Kris-Sekula/NABU/ProtoPCB/Readme.md

Simple PCB for an ad-hoc build of NABU expansion devices. All NABU signals are labeled for ease of connection.

Sources are in KiCad 6.0, you can use those to create gerbers or simply order from [PCBWay](https://www.pcbway.com/project/shareproject/NABU_PC_Prototyping_PCB_ee055662.html)

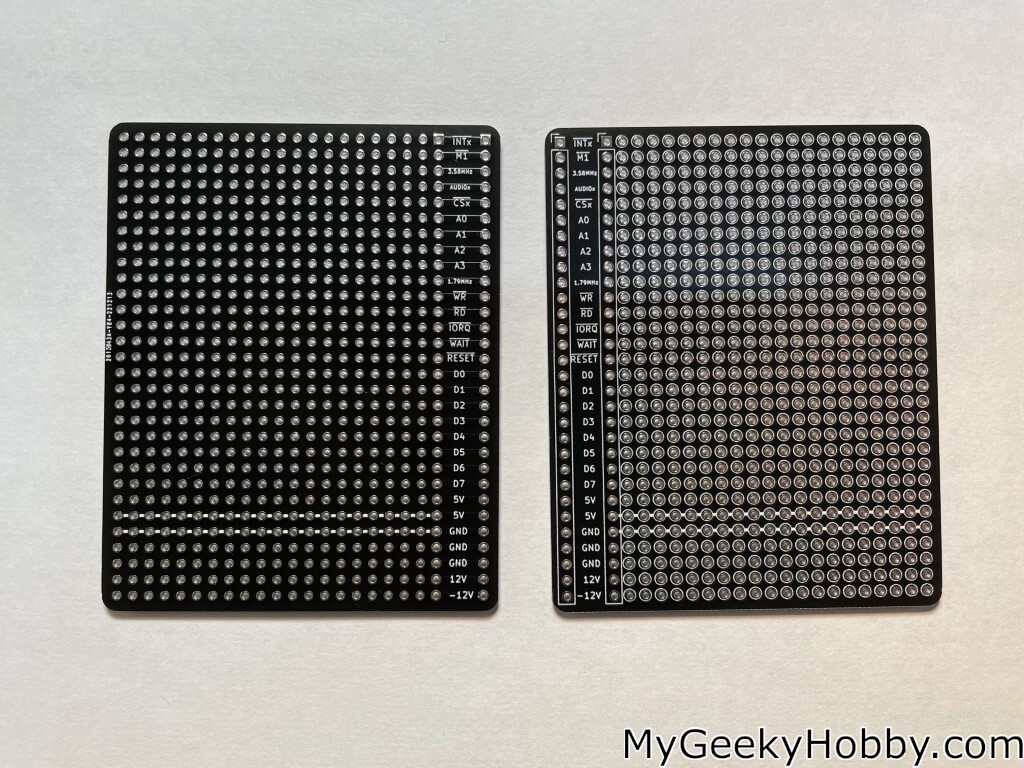
[picture p1: ProtoPCB/Pictures/ProtoPCB.jpg]
ProtoPCB


And here is an example of using the proto PCB to build a CF card adapter for NABU and run CP/M (as per those [Instructions](https://github.com/randomvariations/nabu.cpm/tree/main/cpm22))

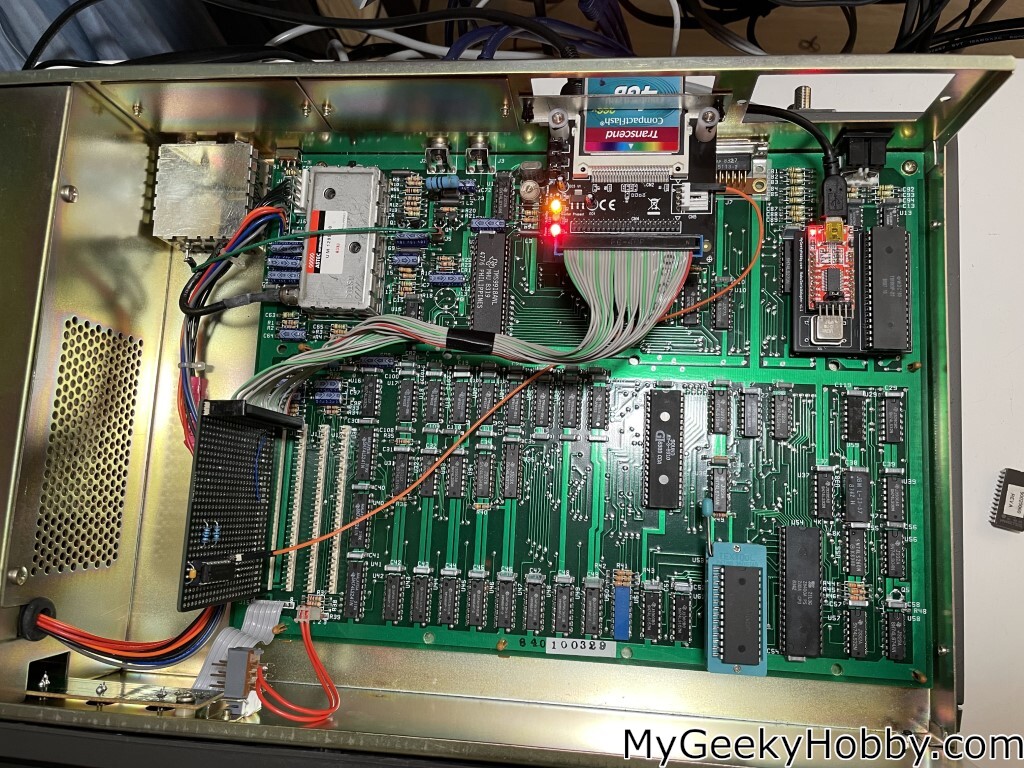
[picture p2: ProtoPCB/Pictures/CF_adapter_usingProto.jpg]
CF_Adapter
