Kris-Sekula/NABU/RS422Alternative/Readme.md

Diagram of a serial port implemented with a simple USB<->TTL adapter and [YouTube-video](https://youtu.be/NxW2GOw5Mqk)

KiCad PCB desing in the hardware folder

It works! ... well it "worked"...fine with the first version of the Nabu software, but now something has changed... so this adapter only works with the alternative "monitor" that I tested ... see my YouTube video.
NABU-Online

Detailed Diagram
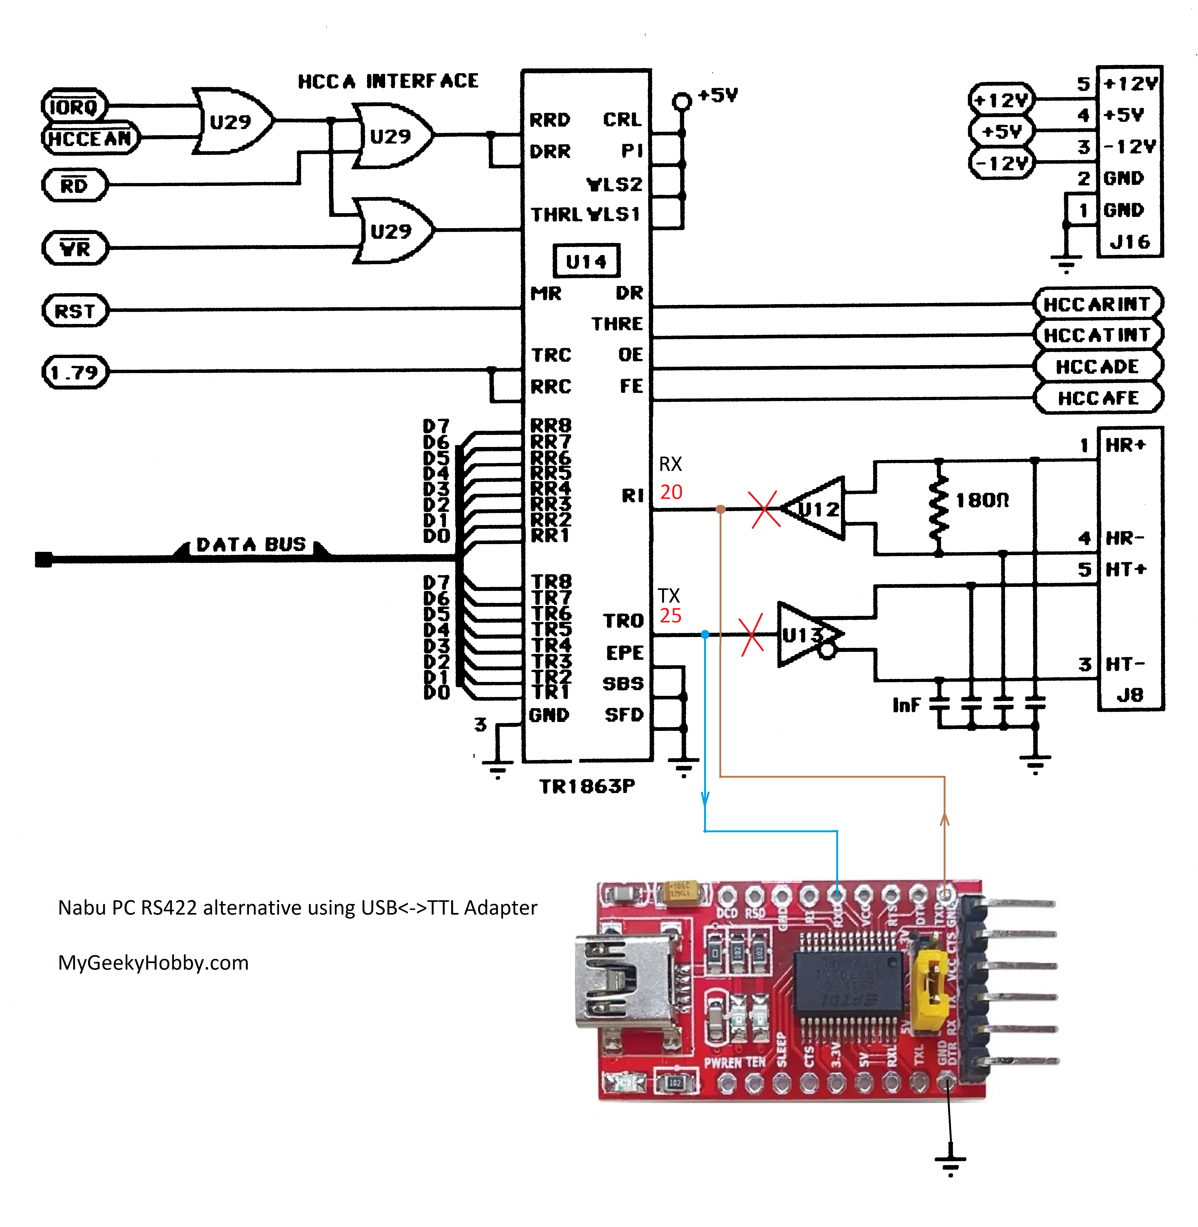
[picture p4: RS422Alternative/USB_interface.png]
USB-serial-Adapter

I'm also testing virtual com port using ESP8266 and the esp-link firmware
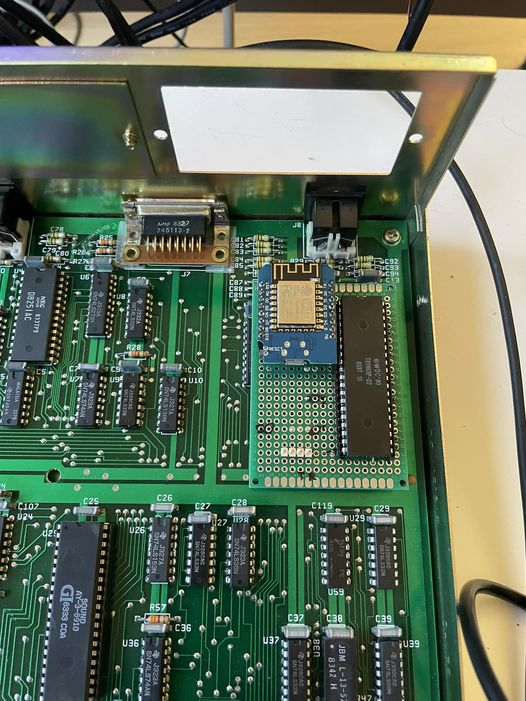
[picture p5: RS422Alternative/esp-nabu.jpg]
esp-link
