Kris-Sekula/NABU/RS422Alternative/Hardware/nabu_serial.pdf

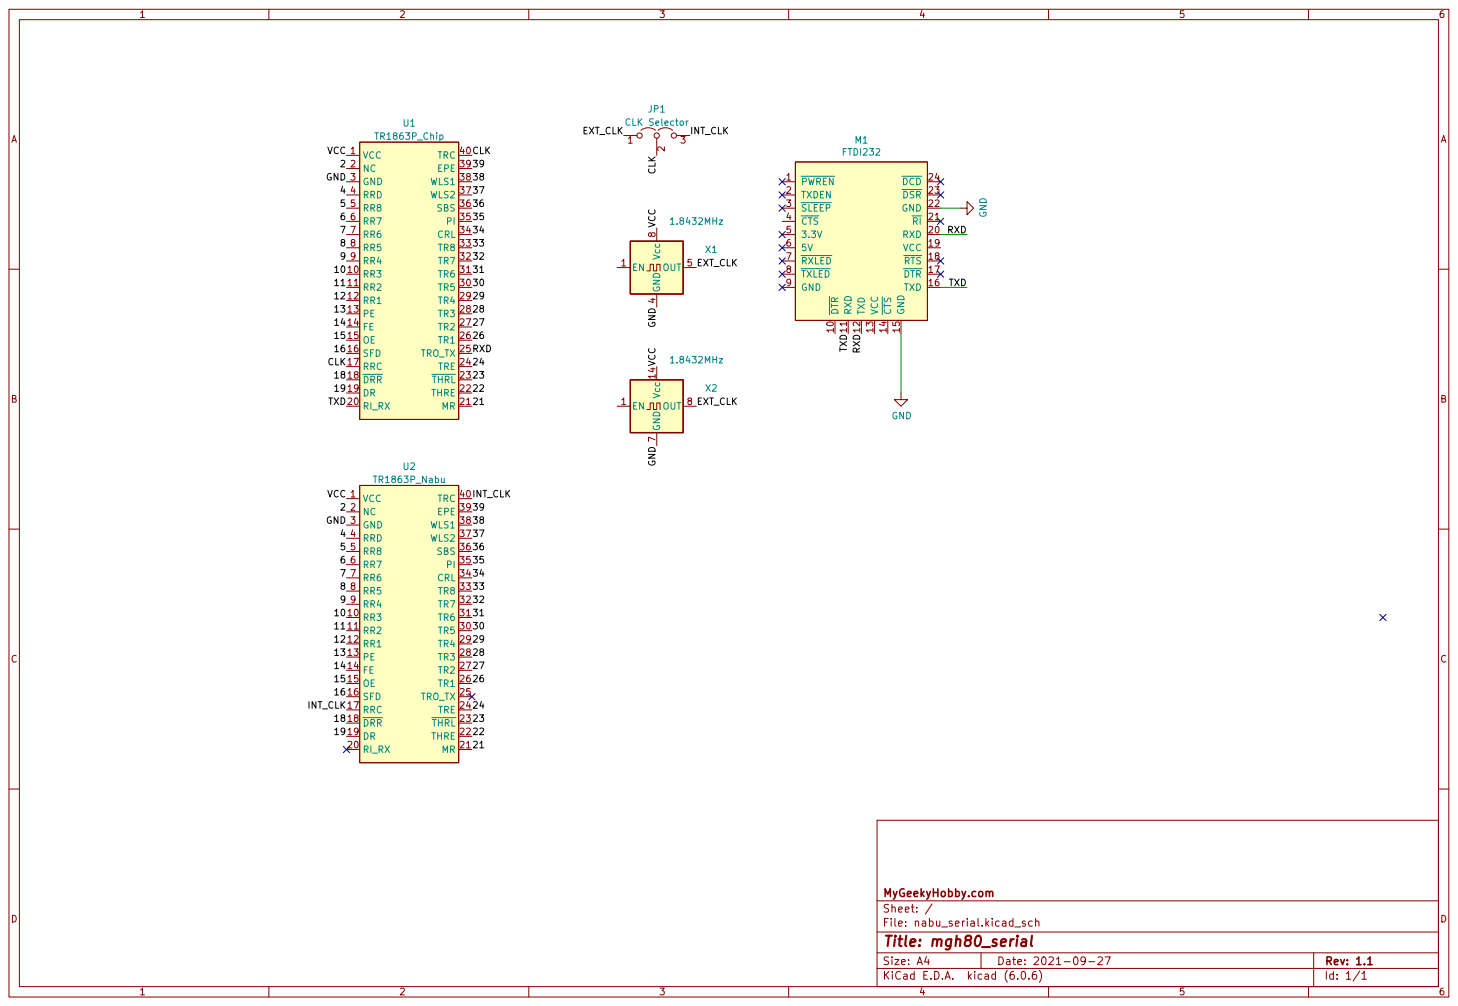
[picture p8: page 1]

File: nabu_serial.kicad_sch Sheet: / MyGeekyHobby.com
