Kris-Sekula/NABU/RS422Alternative/Hardware/nabu_serial.kicad_pcb

## KiCad design RS422Alternative/Hardware/nabu_serial.kicad_pcb (2022-12-31)

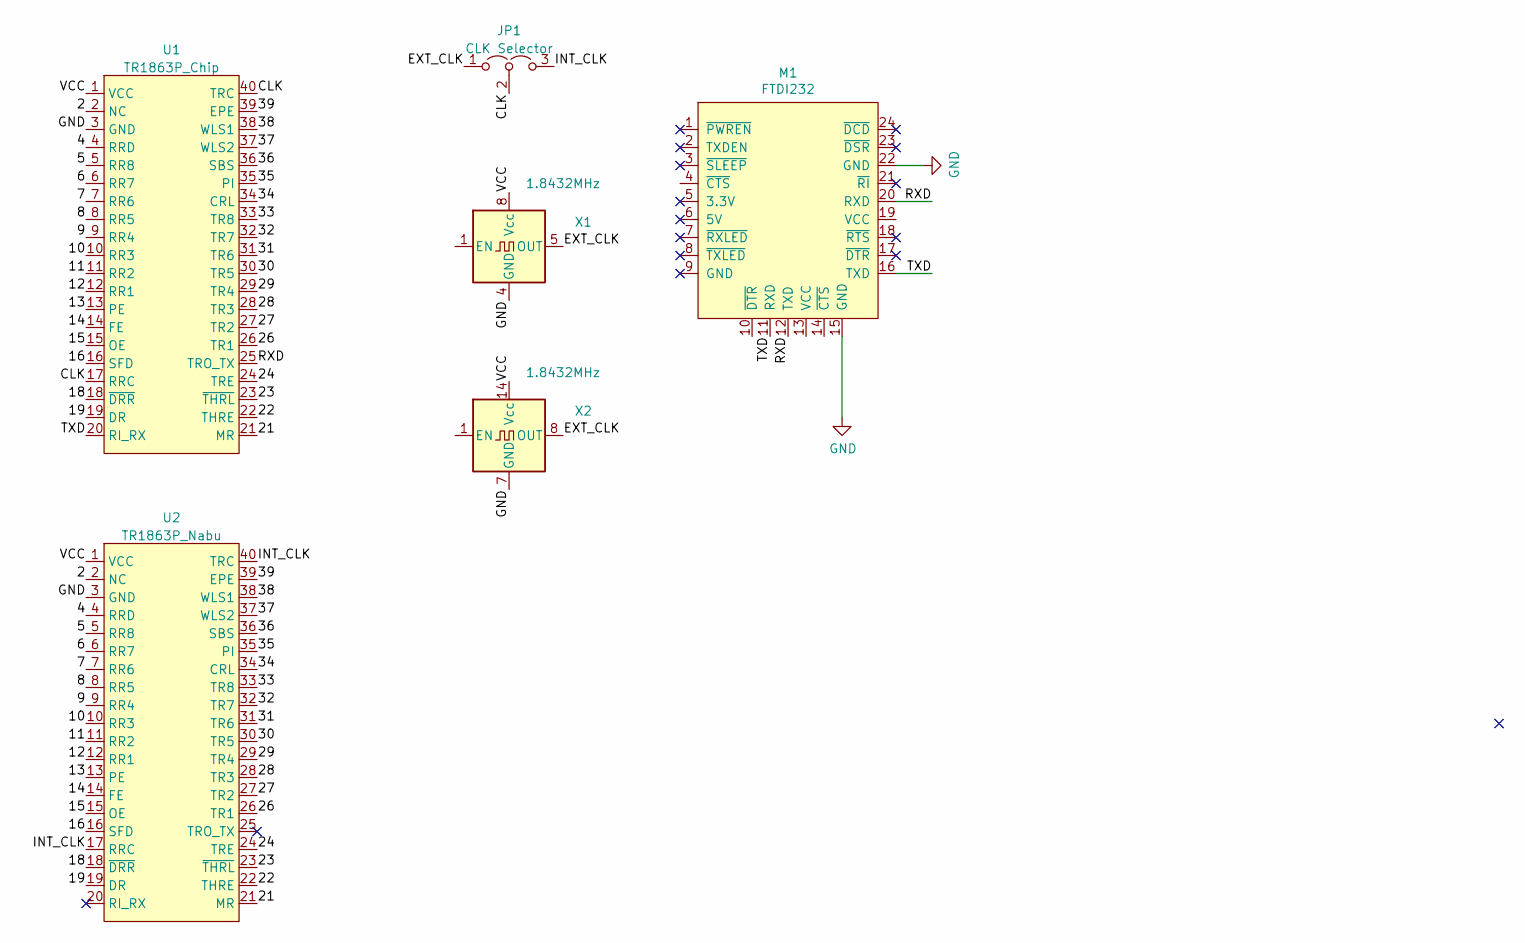
[picture p9: schematic nabu_serial.kicad_sch, mgh80_serial]

Parts:
JP1: CLK Selector; SolderJumper-3_P2.0mm_Open_TrianglePad1.0x1.5mm
M1: FTDI232; FTDI232_Full
U1: TR1863P_Chip; DIP-40_W15.24mm_Socket
U2: TR1863P_Nabu; DIP-40_W15.24mm_Socket
X1: 1.8432MHz; Oscillator_DIP-8
X2: 1.8432MHz; Oscillator_DIP-14

Connections:
/2: U1.2 (NC), U2.2 (NC)
/4: U1.4 (RRD), U2.4 (RRD)
/5: U1.5 (RR8), U2.5 (RR8)
/6: U1.6 (RR7), U2.6 (RR7)
/7: U1.7 (RR6), U2.7 (RR6)
/8: U1.8 (RR5), U2.8 (RR5)
/9: U1.9 (RR4), U2.9 (RR4)
/10: U1.10 (RR3), U2.10 (RR3)
/11: U1.11 (RR2), U2.11 (RR2)
/12: U1.12 (RR1), U2.12 (RR1)
/13: U1.13 (PE), U2.13 (PE)
/14: U1.14 (FE), U2.14 (FE)
/15: U1.15 (OE), U2.15 (OE)
/16: U1.16 (SFD), U2.16 (SFD)
/18: U1.18 (~DRR), U2.18 (~DRR)
/19: U1.19 (DR), U2.19 (DR)
/21: U1.21 (MR), U2.21 (MR)
/22: U1.22 (THRE), U2.22 (THRE)
/23: U1.23 (~THRL), U2.23 (~THRL)
/24: U1.24 (TRE), U2.24 (TRE)
/26: U1.26 (TR1), U2.26 (TR1)
/27: U1.27 (TR2), U2.27 (TR2)
/28: U1.28 (TR3), U2.28 (TR3)
/29: U1.29 (TR4), U2.29 (TR4)
/30: U1.30 (TR5), U2.30 (TR5)
/31: U1.31 (TR6), U2.31 (TR6)
/32: U1.32 (TR7), U2.32 (TR7)
/33: U1.33 (TR8), U2.33 (TR8)
/34: U1.34 (CRL), U2.34 (CRL)
/35: U1.35 (PI), U2.35 (PI)
/36: U1.36 (SBS), U2.36 (SBS)
/37: U1.37 (WLS2), U2.37 (WLS2)
/38: U1.38 (WLS1), U2.38 (WLS1)
/39: U1.39 (EPE), U2.39 (EPE)
/CLK: JP1.2 (C), U1.17 (RRC), U1.40 (TRC)
/EXT_CLK: JP1.1 (A), X1.5 (OUT), X2.8 (OUT)
/INT_CLK: JP1.3 (B), U2.17 (RRC), U2.40 (TRC)
/RXD: M1.12 (TXD), M1.20 (RXD), U1.25 (TRO_TX)
/TXD: M1.11 (RXD), M1.16 (TXD), U1.20 (RI_RX)
/VCC: U1.1 (VCC), U2.1 (VCC), X1.8 (Vcc), X2.14 (Vcc)
GND: M1.15 (GND), M1.22 (GND), U1.3 (GND), U2.3 (GND), X1.4 (GND), X2.7 (GND)

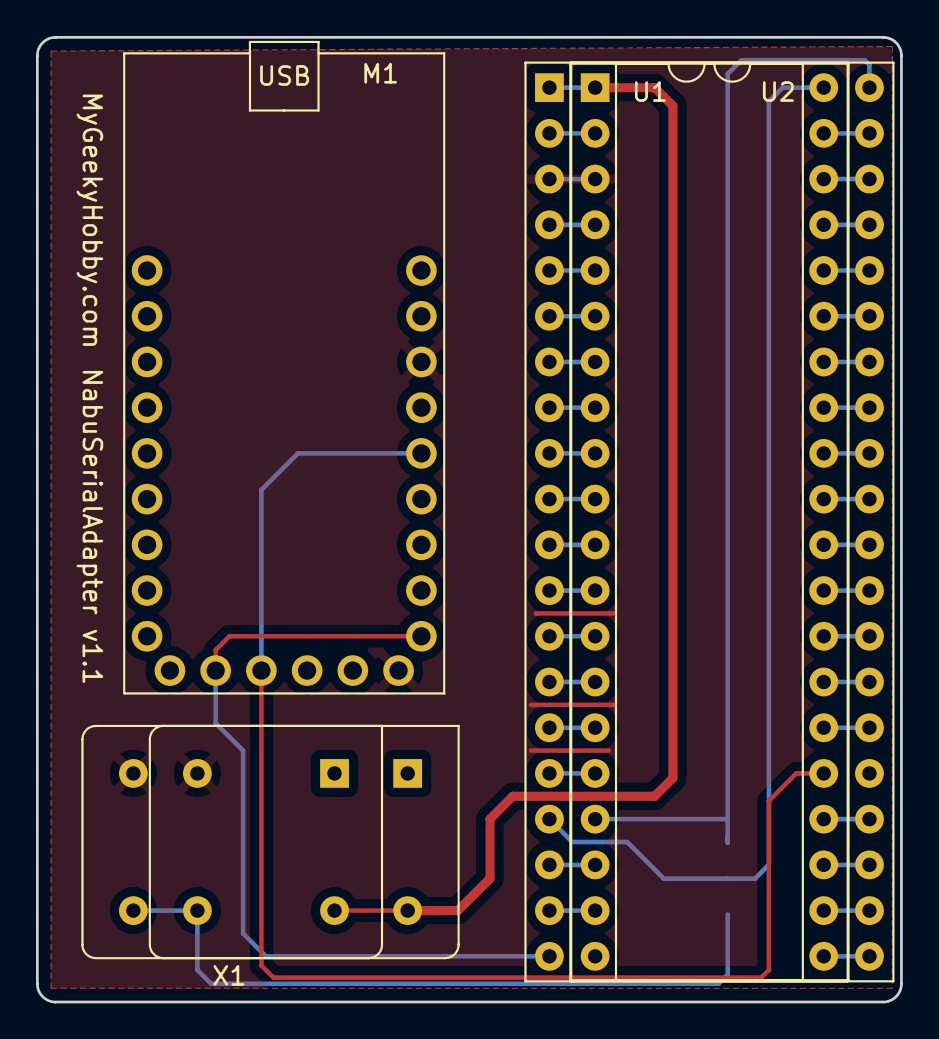
[picture p10: board nabu_serial.kicad_pcb from above]

Board: 2 copper layers, 48.0 x 53.6 mm, 6 parts (1 on the bottom side), 41 nets.
