Kris-Sekula/NABU/(commit log)

2022-12-31 Added PDF schematic
2022-12-31 Updated BOM
2023-01-01 KiCad sources added
    [NabuProtoPCB.kicad_pcb, NabuProtoPCB.kicad_sch]
