Kris-Sekula/NABU/RS422Alternative/NABU_online.jpg

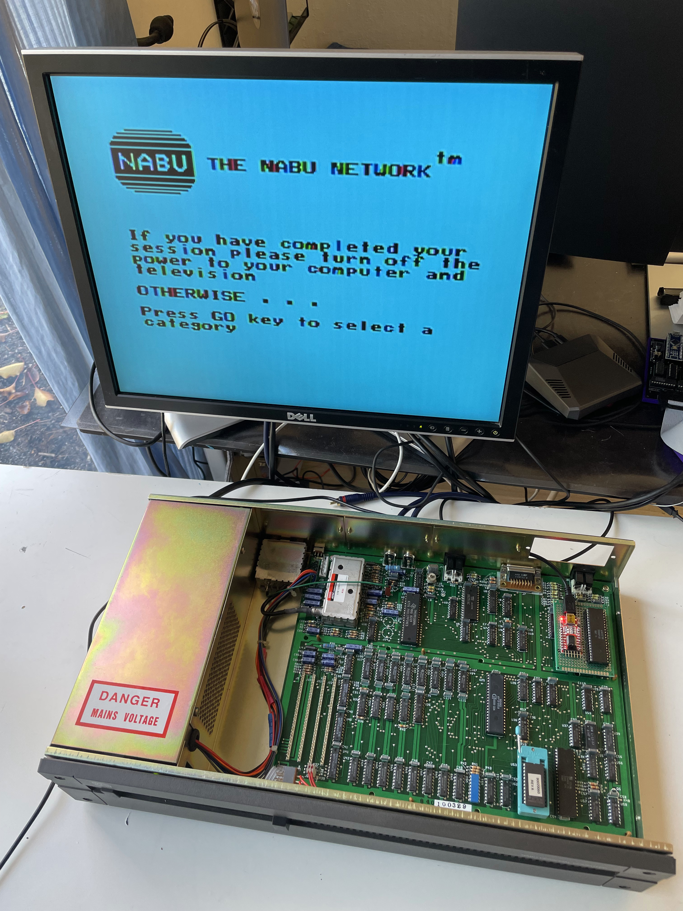
[picture p3: RS422Alternative/NABU_online.jpg]
RS422Alternative/NABU_online.jpg
